ansiwen/dualjoy/hardware/kicad/dualjoy.kicad_pcb

## KiCad design hardware/kicad/dualjoy.kicad_pcb (2026-10-12)

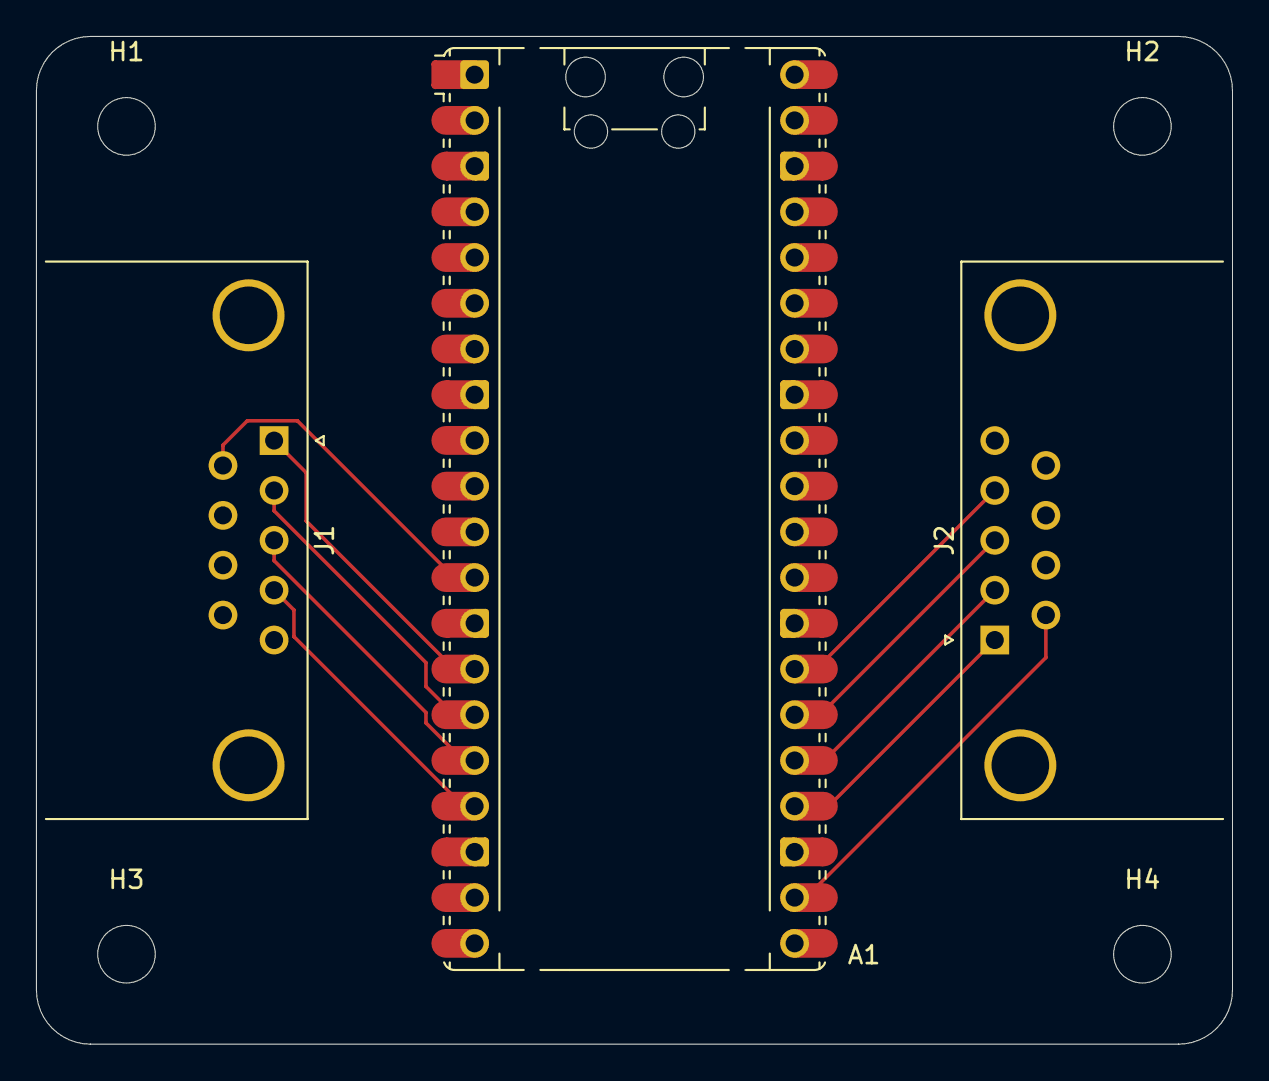
[picture p8: board dualjoy.kicad_pcb from above]

Board: 2 copper layers, 66.4 x 56.0 mm, 7 parts (0 on the bottom side), 11 nets.

Parts:
A1: RaspberryPi_Pico; RaspberryPi_Pico_Common_Unspecified
H1, H2, H3, H4: MountingHole_3.2mm_M3
J1, J2: DE9_Pins; DSUB-9_Pins_Horizontal_P2.77x2.84mm_EdgePinOffset9.90mm_Hou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

Connections:
GND: A1.3 (GND), A1.8 (GND), A1.13 (GND), A1.18 (GND), A1.23 (GND), A1.28 (GND), A1.38 (GND), J1.8, J2.8
unnamed: A1.12 (GPIO9), J1.6
unnamed: A1.14 (GPIO10), J1.1
unnamed: A1.15 (GPIO11), J1.2
unnamed: A1.16 (GPIO12), J1.3
unnamed: A1.17 (GPIO13), J1.4
unnamed: A1.22 (GPIO17), J2.6
unnamed: A1.24 (GPIO18), J2.1
unnamed: A1.25 (GPIO19), J2.2
unnamed: A1.26 (GPIO20), J2.3
unnamed: A1.27 (GPIO21), J2.4
